essec-lab/sharmony/docs/figures/compression_core.pdf

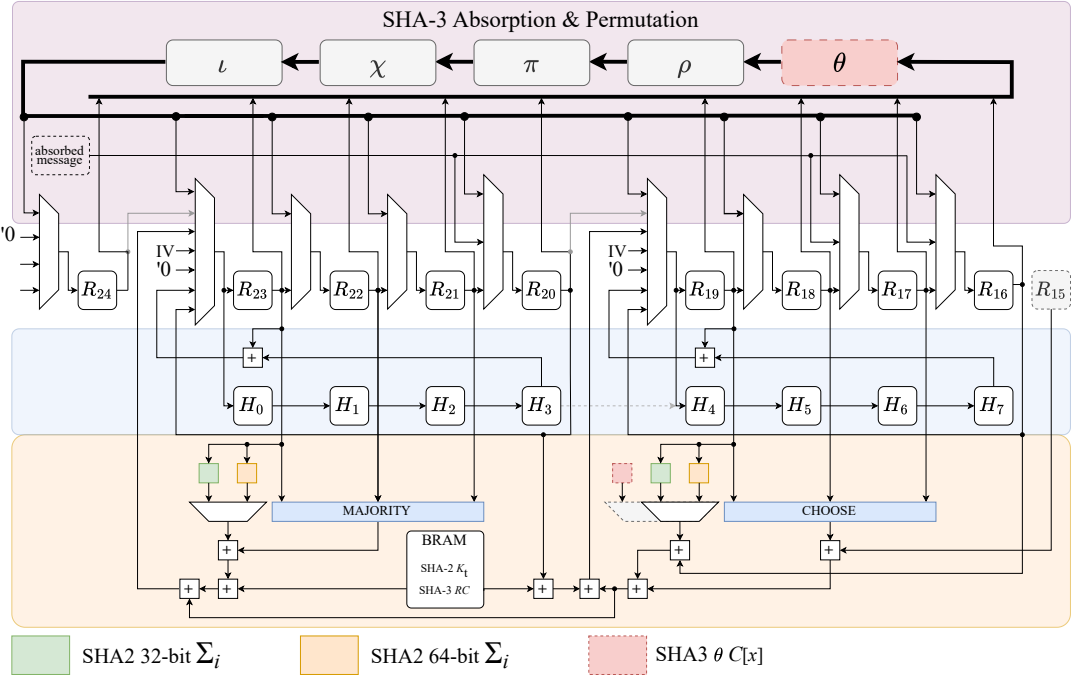
[picture p17: page 1]
MAJORITY; CHOOSE; SHA-2 Kt SHA-3 RC; BRAM; absorbed message; SHA2 32-bit Σi; SHA2 64-bit Σi; SHA3 C[x]

SHA-3 Absorption & Permutation
