essec-lab/sharmony/docs/figures/constants_rom.pdf

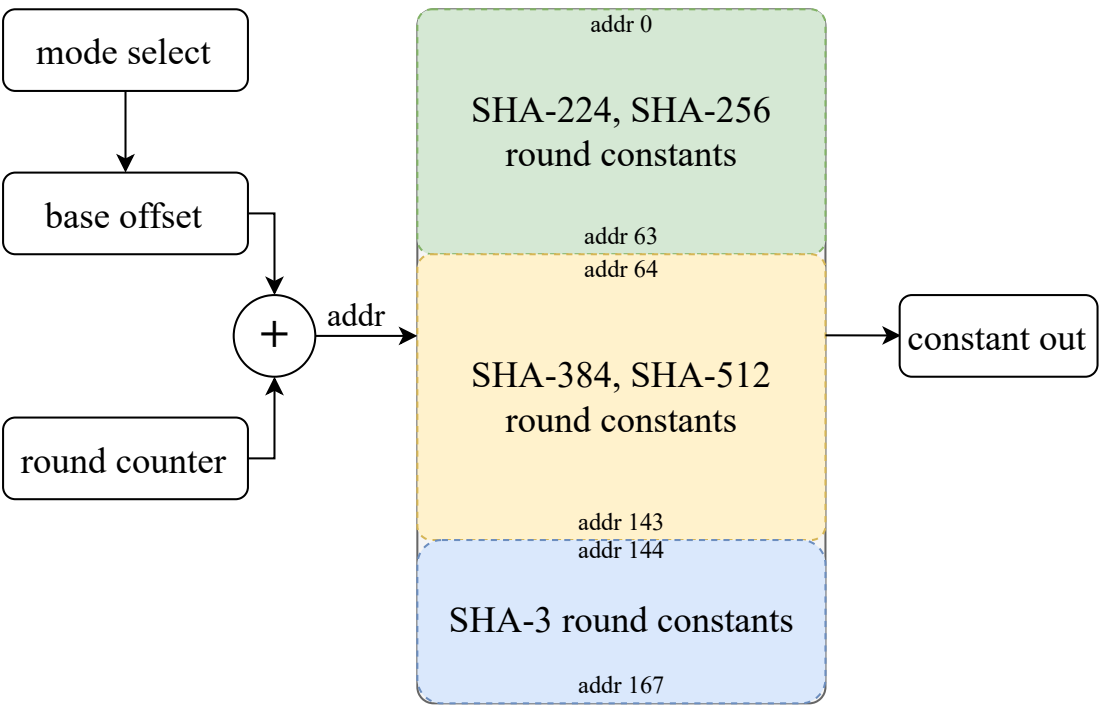
[picture p18: page 1]
addr; base offset; mode select; round counter; SHA-224, SHA-256 round constants; SHA-384, SHA-512 round constants; constant out; addr 0; addr 63 addr 64; addr 167

addr 143
addr 144
SHA-3 round constants
