essec-lab/sharmony/docs/figures/msg_scheduler.pdf

## SHA-3 Absorption & Permutation

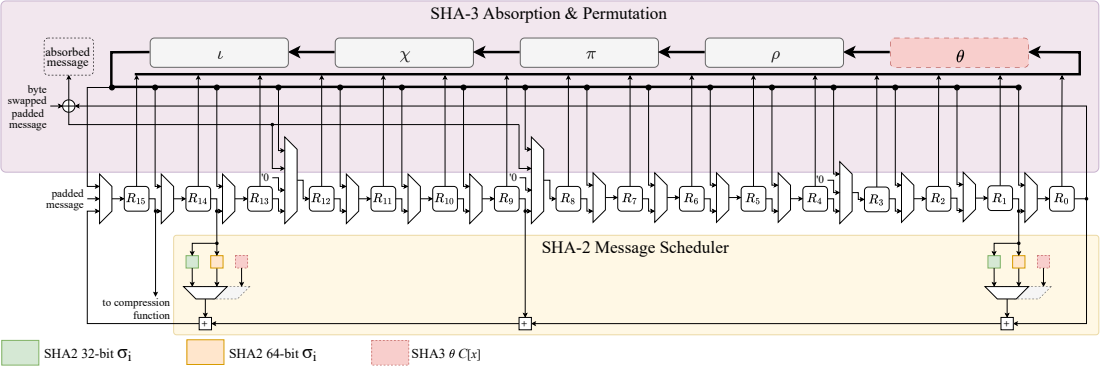
[picture p19: page 1]
padded message; absorbed message; byte swapped padded message; to compression function; SHA2 32-bit σi; SHA2 64-bit σi; SHA3 C[x]

SHA-2 Message Scheduler
