essec-lab/sharmony/docs/figures/sharmony_top.pdf

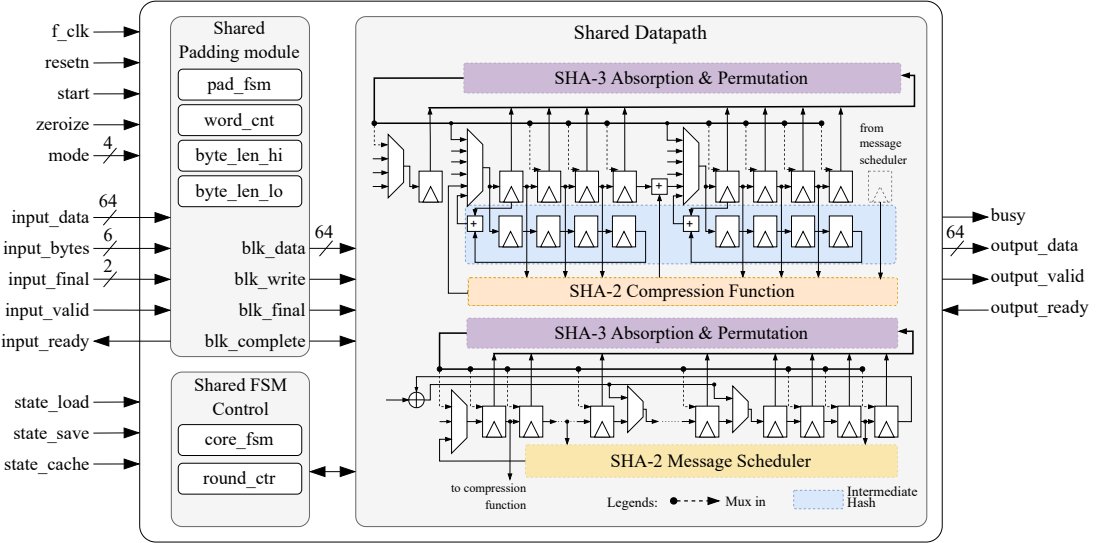
[picture p20: page 1]
mode; f_clk resetn; zeroize; start; input_data; input_bytes input_final input_valid; input_ready; pad_fsm; Shared Padding module; byte_len_hi; blk_data; blk_complete; output_data output_valid; Shared FSM Control core_fsm; round_ctr; Legends:; Mux in; Intermediate Hash; output_ready; state_cache; state_save; state_load; blk_final; blk_write; busy; to compression function; byte_len_lo; word_cnt; from; message scheduler

Shared Datapath
SHA-3 Absorption & Permutation

SHA-2 Compression Function ⁺

SHA-2 Compression Function

SHA-2 Message Scheduler
