essec-lab/sharmony/docs/waveforms/error.pdf

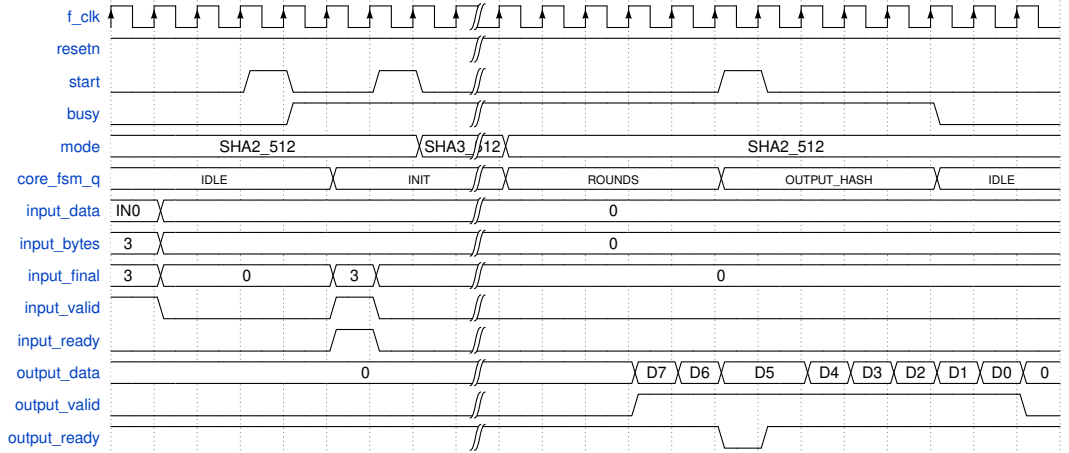
[picture p21: page 1]
