essec-lab/sharmony/docs/waveforms/midstate_resume.pdf

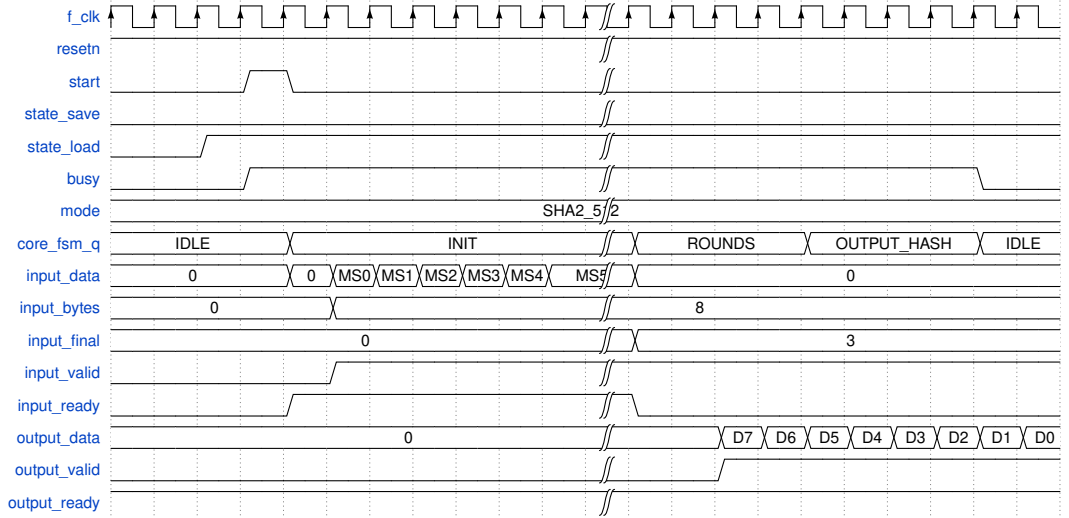
[picture p22: page 1]
