essec-lab/sharmony/docs/waveforms/output_handshake.pdf

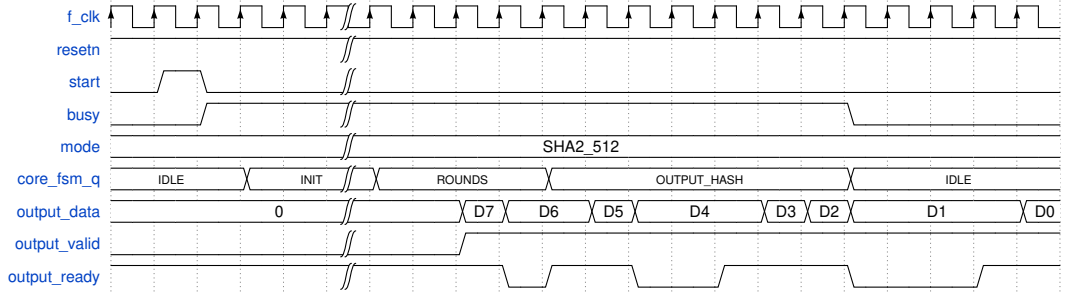
[picture p23: page 1]
