essec-lab/sharmony/docs/waveforms/sha512_shortmsg.pdf

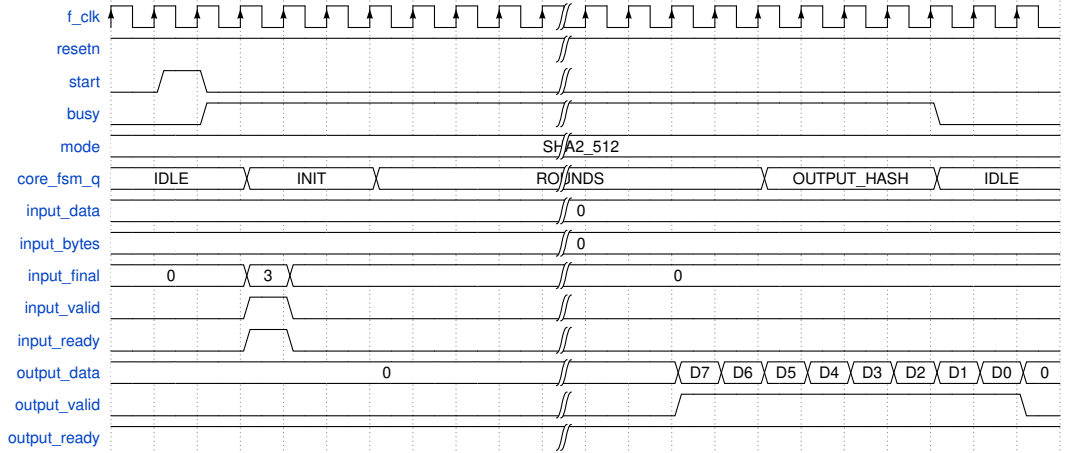
[picture p24: page 1]
