essec-lab/sharmony/docs/waveforms/shake256_variableout.pdf

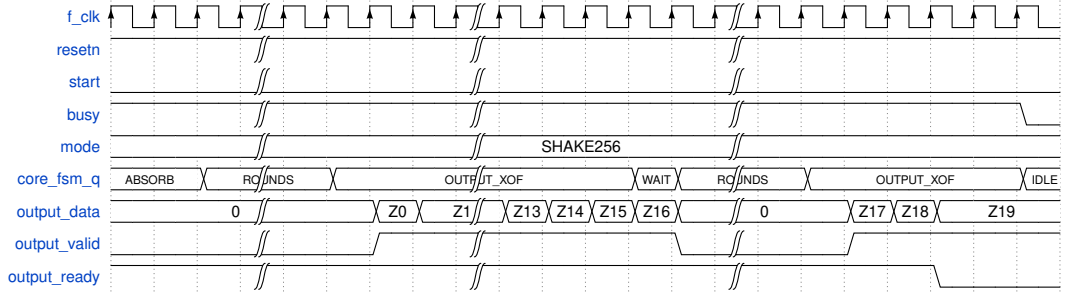
[picture p25: page 1]
f_clk; resetn; start; busy; mode; SHAKE256; core_fsm_q; ABSORB; ROUNDS; OUTPUT_XOF; WAIT; IDLE; output_data; output_valid; output_ready
