essec-lab/sharmony/docs/waveforms/state_cache_resume.pdf

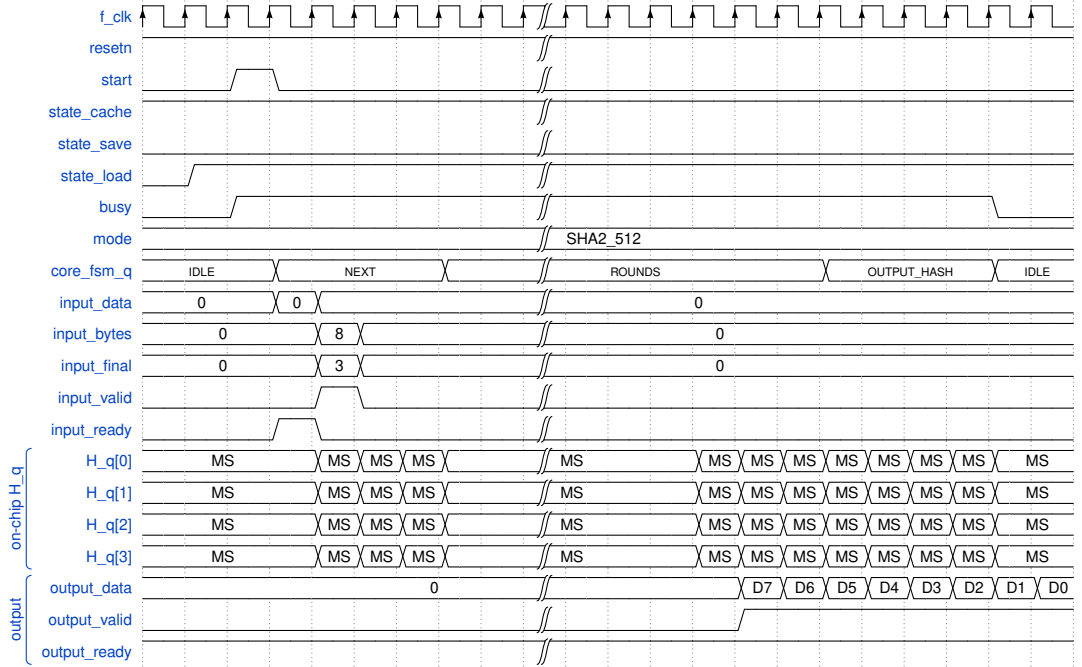
[picture p26: page 1]
