essec-lab/sharmony/docs/waveforms/zeroize.pdf

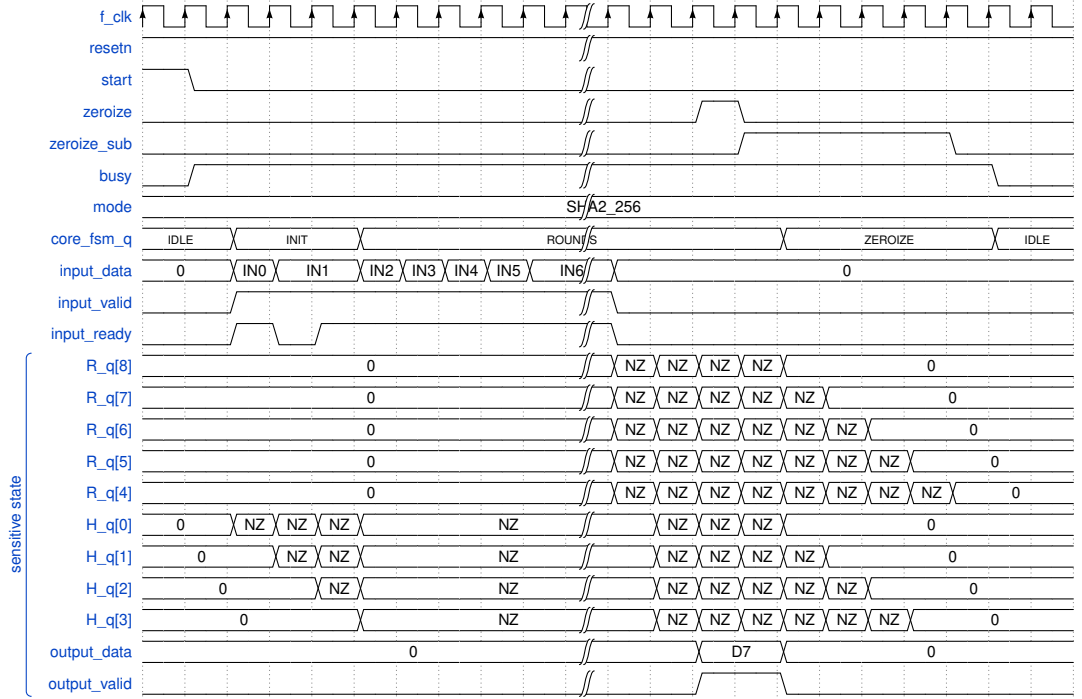
[picture p27: page 1]
f_clk; resetn; start; zeroize; zeroize_sub; busy; mode; SHA2_256; core_fsm_q; IDLE; INIT; ROUNDS; ZEROIZE; input_data; input_valid; input_ready; output_data; output_valid; sensitive state
